edwardatki/PicoDrive/hardware/PicoDrive.kicad_pcb

## KiCad design hardware/PicoDrive.kicad_pcb (2022-10-20)

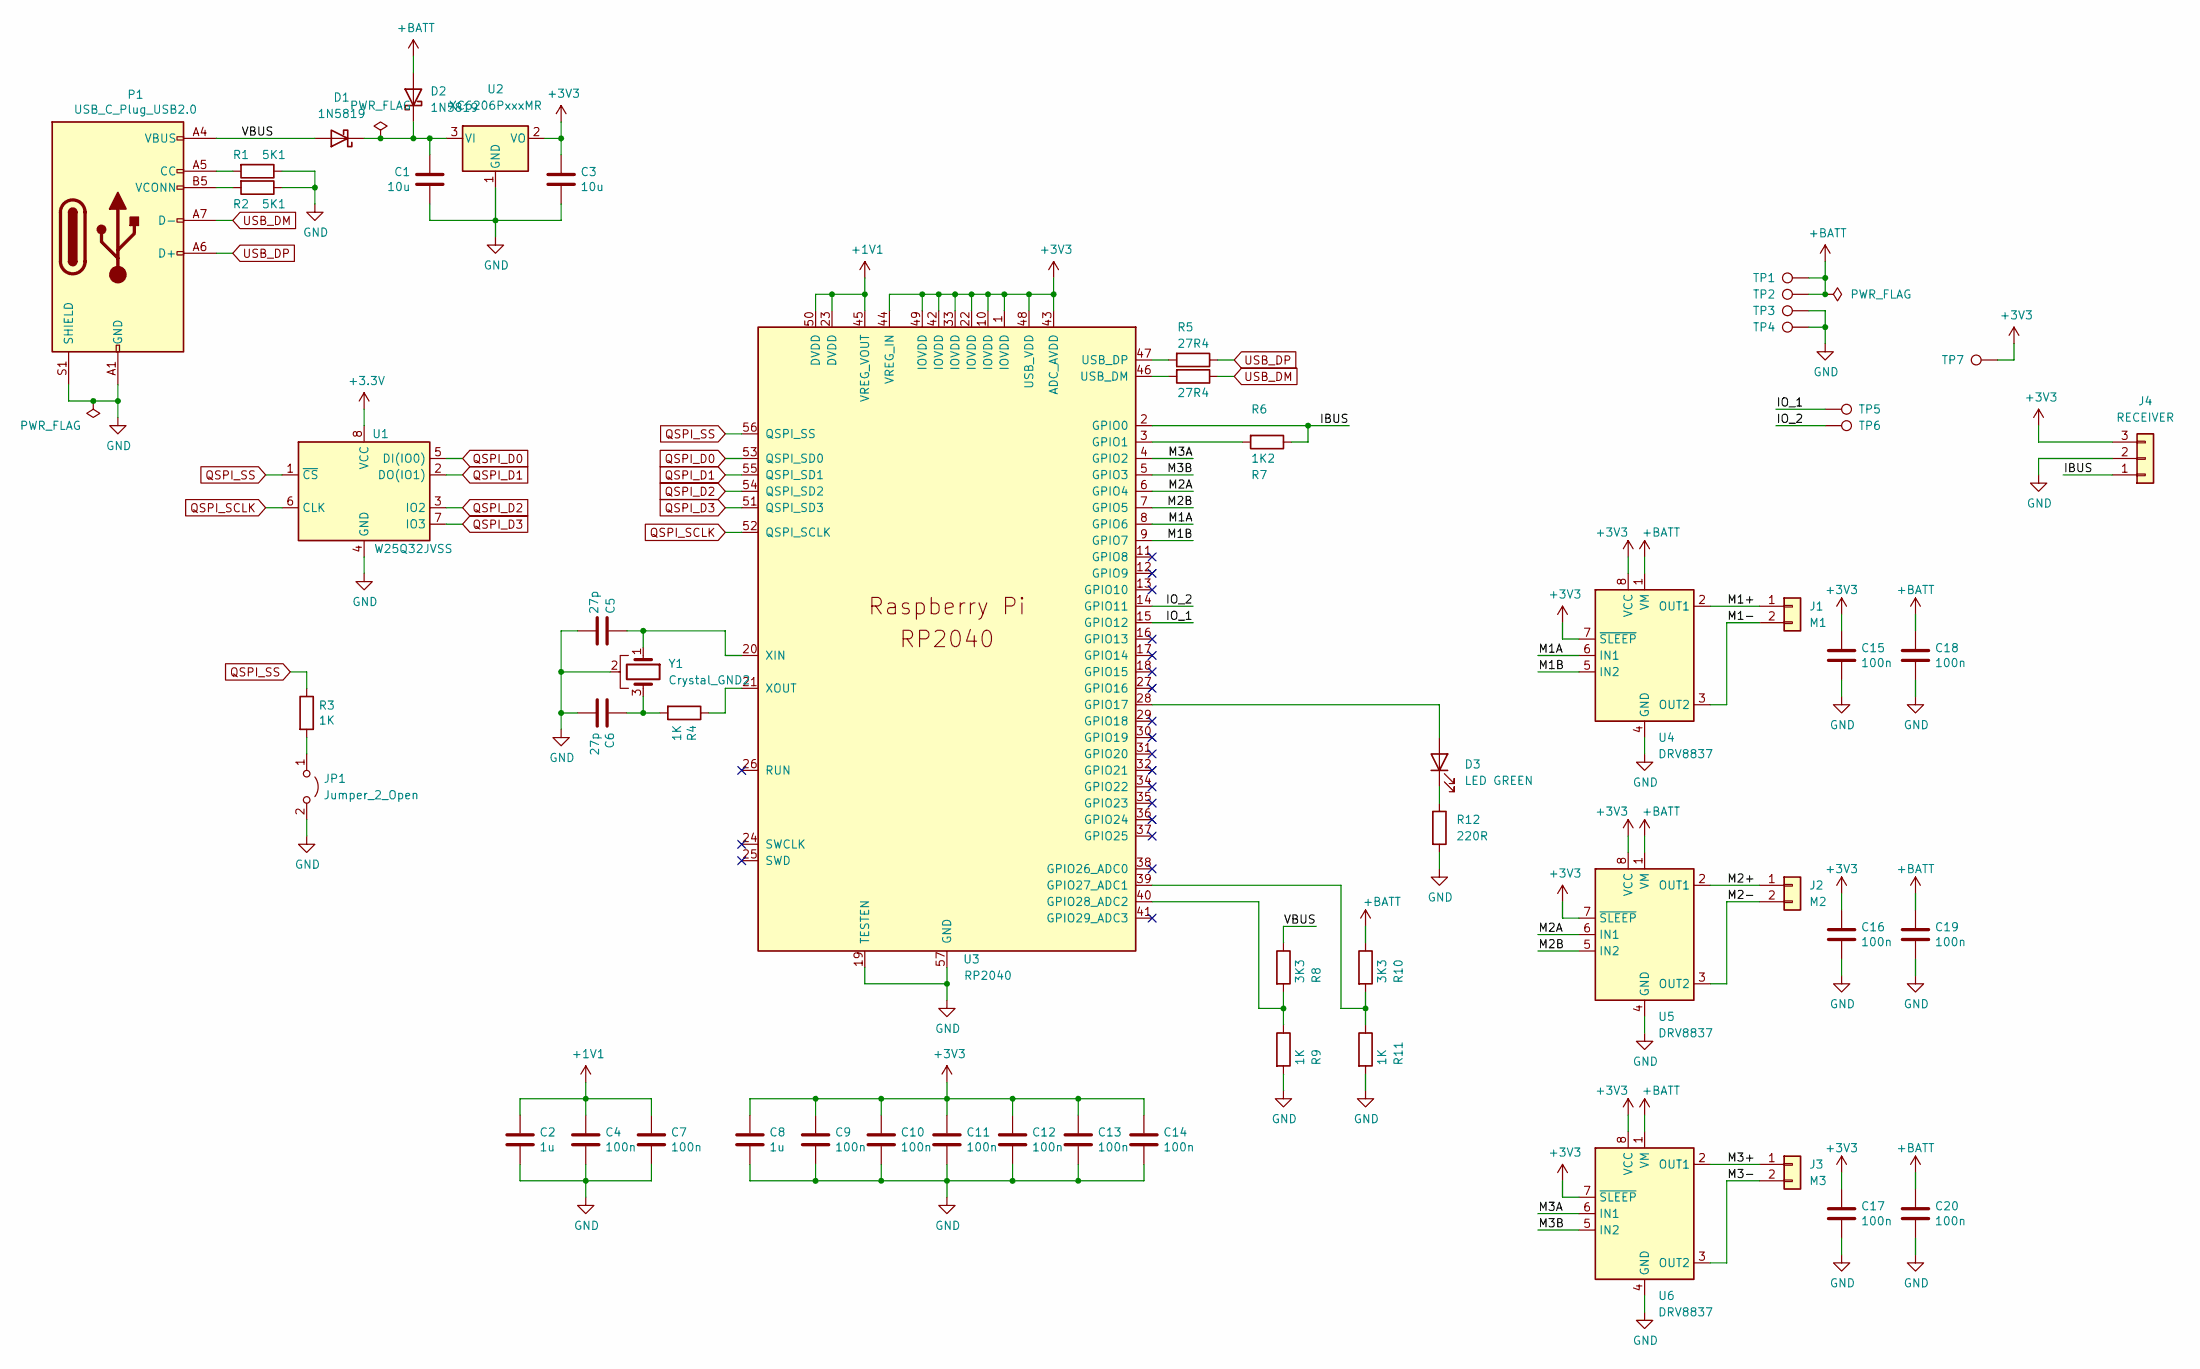
[picture p1: schematic PicoDrive.kicad_sch]

Parts:
C1, C3: 10u; C_0603_1608Metric
C2, C8: 1u; C_0402_1005Metric
C4, C7, C9, C10, C11, C12, C13, C14, C15, C16, C17, C18, C19, C20: 100n; C_0402_1005Metric
C5, C6: 27p; C_0402_1005Metric
D1, D2: 1N5819; D_SOD-323
D3: LED GREEN; LED_0603_1608Metric
J1: M1; JST_SH_SM02B-SRSS-TB_1x02-1MP_P1.00mm_Horizontal
J2: M2; JST_SH_SM02B-SRSS-TB_1x02-1MP_P1.00mm_Horizontal
J3: M3; JST_SH_SM02B-SRSS-TB_1x02-1MP_P1.00mm_Horizontal
J4: RECEIVER; JST_SH_SM03B-SRSS-TB_1x03-1MP_P1.00mm_Horizontal
JP1: Jumper_2_Open; SolderJumper-2_P1.3mm_Open_RoundedPad1.0x1.5mm
P1: USB_C_Plug_USB2.0; USB_C_Receptacle_Palconn_UTC16-G
R1, R2: 5K1; R_0402_1005Metric
R3, R4, R9, R11: 1K; R_0402_1005Metric
R5, R6: 27R4; R_0402_1005Metric
R7: 1K2; R_0402_1005Metric
R8, R10: 3K3; R_0402_1005Metric
R12: 220R; R_0402_1005Metric
TP1, TP2: BAT+; TestPoint_Pad_1.5x1.5mm
TP3, TP4: BAT-; TestPoint_Pad_1.5x1.5mm
TP5: PWM1; TestPoint_Pad_1.5x1.5mm
TP6: PWM2; TestPoint_Pad_1.5x1.5mm
TP7: 3V3; TestPoint_Pad_1.5x1.5mm
U1: W25Q32JVSS; 8-USON
U2: XC6206PxxxMR; SOT-23
U3: RP2040; RP2040-QFN-56
U4, U5, U6: DRV8837; WSON-8-1EP_2x2mm_P0.5mm_EP0.9x1.6mm
Y1: Crystal_GND2; Crystal_SMD_3225-4Pin_3.2x2.5mm

Connections:
+1V1: C2.1, C4.1, C7.1, U3.23 (DVDD), U3.45 (VREG_VOUT), U3.50 (DVDD)
+BATT: C18.1, C19.1, C20.1, D2.2 (A), R10.1, TP1.1, TP2.1, U4.1 (VM), U5.1 (VM), U6.1 (VM)
/IBUS: J4.1, R7.1, U3.2 (GPIO0)
/IO_1: TP5.1, U3.15 (GPIO12)
/IO_2: TP6.1, U3.14 (GPIO11)
/M1+: J1.1, U4.2 (OUT1)
/M1-: J1.2, U4.3 (OUT2)
/M1A: U3.8 (GPIO6), U4.6 (IN1)
/M1B: U3.9 (GPIO7), U4.5 (IN2)
/M2+: J2.1, U5.2 (OUT1)
/M2-: J2.2, U5.3 (OUT2)
/M2A: U3.6 (GPIO4), U5.6 (IN1)
/M2B: U3.7 (GPIO5), U5.5 (IN2)
/M3+: J3.1, U6.2 (OUT1)
/M3-: J3.2, U6.3 (OUT2)
/M3A: U3.4 (GPIO2), U6.6 (IN1)
/M3B: U3.5 (GPIO3), U6.5 (IN2)
/VBUS: D1.2 (A), P1.A4 (VBUS), P1.A9 (VBUS), P1.B4 (VBUS), P1.B9 (VBUS), R8.1
GND: C1.2, C2.2, C3.2, C4.2, C5.2, C6.2, C7.2, C8.2, C9.2, C10.2, C11.2, C12.2, C13.2, C14.2, C15.2, C16.2, C17.2, C18.2, C19.2, C20.2, J4.2, JP1.2 (B), P1.A1 (GND), P1.A12 (GND), P1.B1 (GND), P1.B12 (GND), P1.S1 (SHIELD), R1.1, R2.1, R9.2, R11.2, R12.2, TP3.1, TP4.1, U1.4 (GND), U2.1 (GND), U3.19 (TESTEN), U3.57 (GND), U4.4 (GND), U4.9 (GND), U5.4 (GND), U5.9 (GND), U6.4 (GND), U6.9 (GND), Y1.2
unnamed: C1.1, D1.1 (K), D2.1 (K), U2.3 (VI)
unnamed: C5.1, U3.20 (XIN), Y1.1
unnamed: C6.1, R4.2, Y1.3
unnamed: D3.1 (K), R12.1
unnamed: D3.2 (A), U3.28 (GPIO17)
unnamed: JP1.1 (A), R3.2
unnamed: P1.A5 (CC), R1.2
unnamed: P1.B5 (VCONN), R2.2
unnamed: R4.1, U3.21 (XOUT)
unnamed: R5.2, U3.47 (USB_DP)
unnamed: R6.2, U3.46 (USB_DM)
unnamed: R7.2, U3.3 (GPIO1)
unnamed: R8.2, R9.1, U3.40 (GPIO28_ADC2)
unnamed: R10.2, R11.1, U3.39 (GPIO27_ADC1)
QSPI_D0: U1.5 (DI(IO0)), U3.53 (QSPI_SD0)
QSPI_D1: U1.2 (DO(IO1)), U3.55 (QSPI_SD1)
QSPI_D2: U1.3 (IO2), U3.54 (QSPI_SD2)
QSPI_D3: U1.7 (IO3), U3.51 (QSPI_SD3)
QSPI_SCLK: U1.6 (CLK), U3.52 (QSPI_SCLK)
QSPI_SS: R3.1, U1.1 (~CS), U3.56 (QSPI_SS)
USB_DM: P1.A7 (D-), R6.1
USB_DP: P1.A6 (D+), R5.1

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
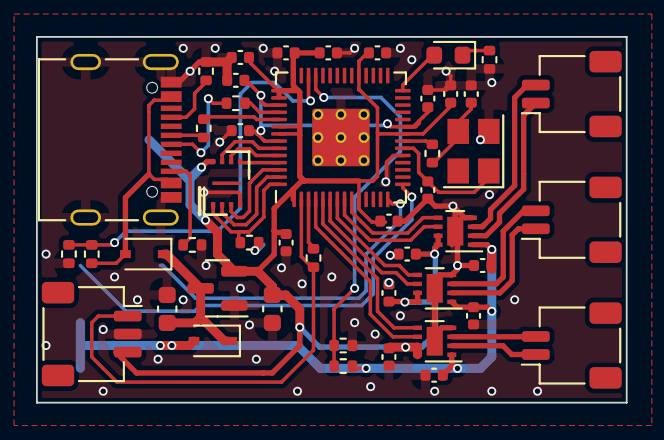
[picture p2: board PicoDrive.kicad_pcb from above]

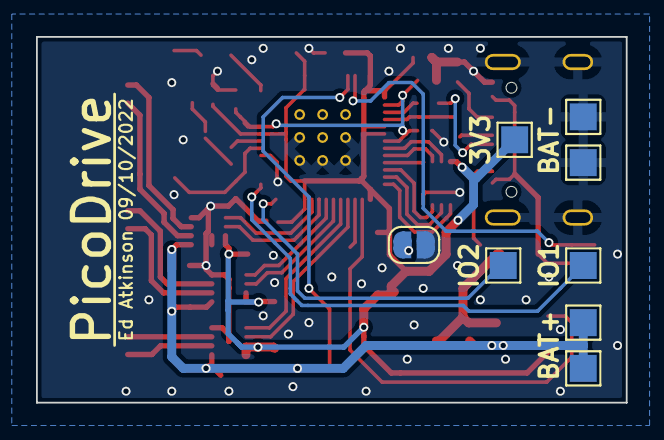
[picture p3: board PicoDrive.kicad_pcb from below]

Board: 2 copper layers, 32.8 x 20.3 mm, 55 parts (8 on the bottom side), 42 nets.
