edwardatki/PicoDrive/(commit log)

2022-10-09 As ordered
    [PicoDrive-CuBottom.gbr, PicoDrive-CuTop.gbr, PicoDrive-EdgeCuts.gbr, PicoDrive-MaskBottom.gbr, PicoDrive-MaskTop.gbr, PicoDrive-NPTH.drl, PicoDrive-PTH.drl, PicoDrive-PasteBottom.gbr]
2022-10-20 Started firmware
    Also fixed an error on the PCB layout
    [PicoDrive-CuBottom.gbr, PicoDrive-CuTop.gbr, PicoDrive-EdgeCuts.gbr, PicoDrive-MaskBottom.gbr, PicoDrive-MaskTop.gbr, PicoDrive-NPTH.drl, PicoDrive-PTH.drl, PicoDrive-PasteBottom.gbr]
2022-10-24 More firmware and some schematic updates
    [PicoDrive.kicad_sch]
